timwaizenegger/rfblaster/doc/04-smarthome.pdf

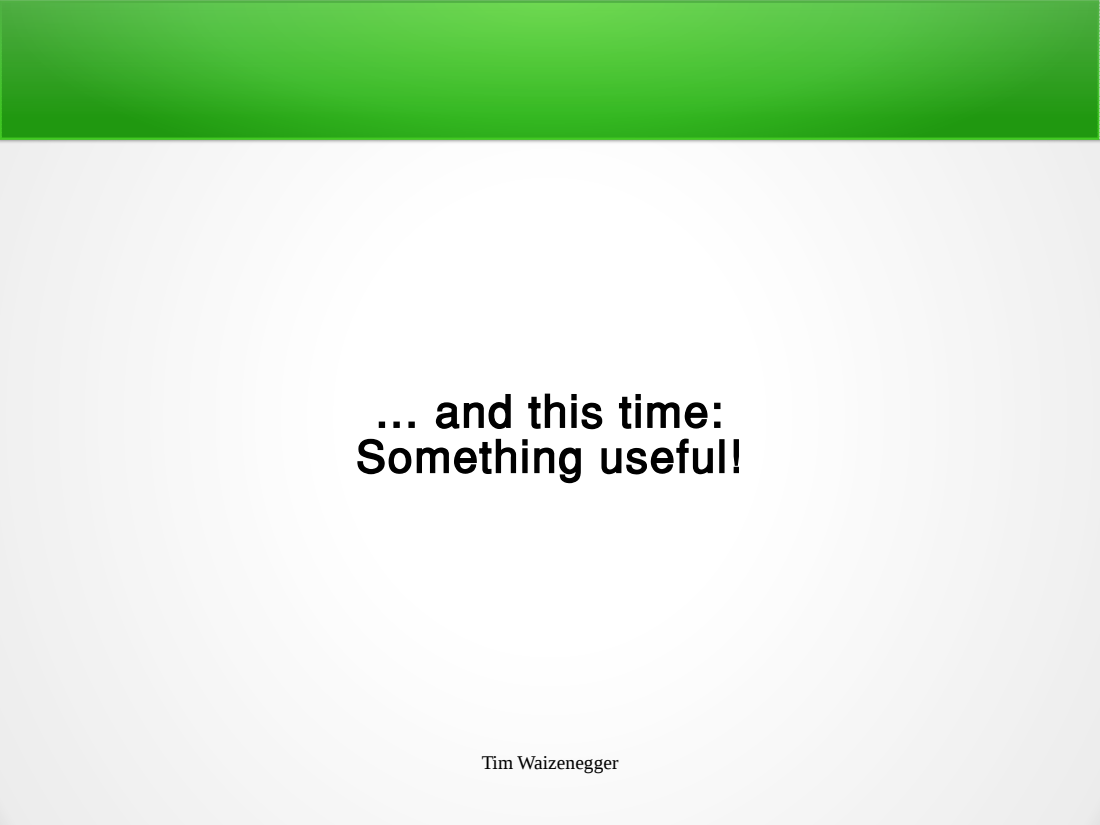
[picture p10: page 1]
Tim Waizenegger

… and this time:
Something useful!

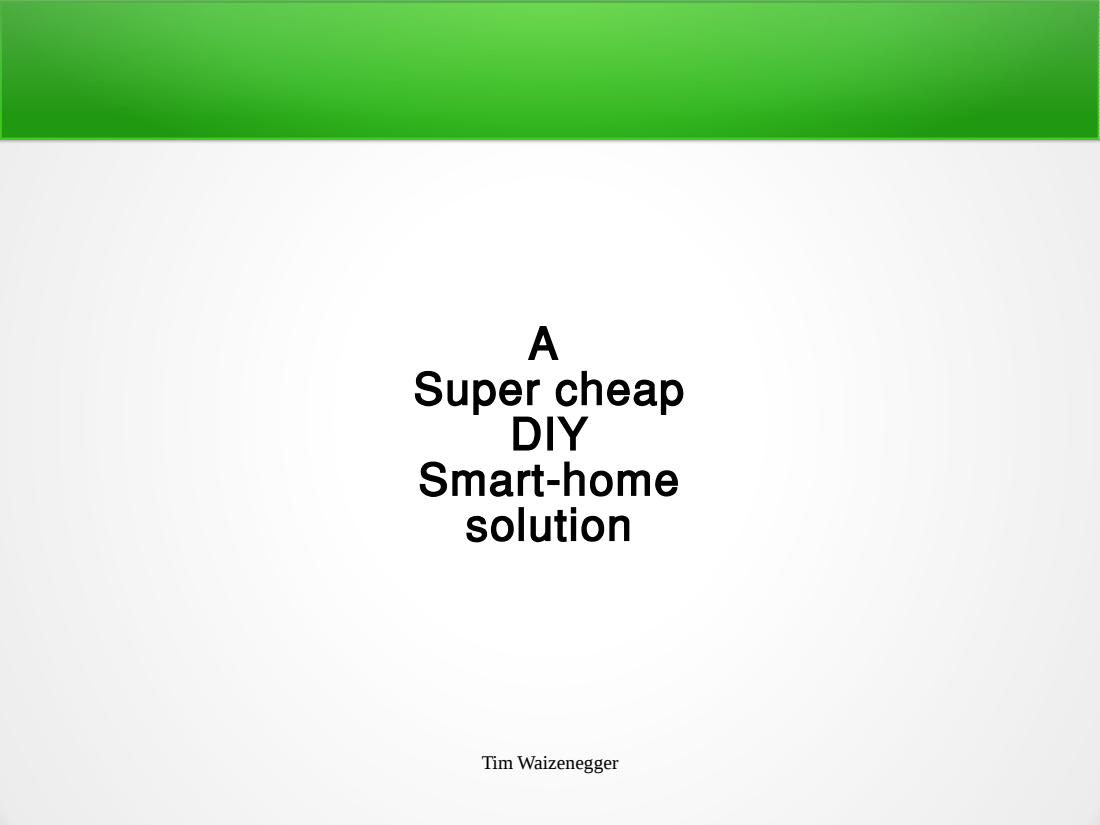
[picture p11: page 2]
A Super cheap DIY Smart-home solution

## Agenda

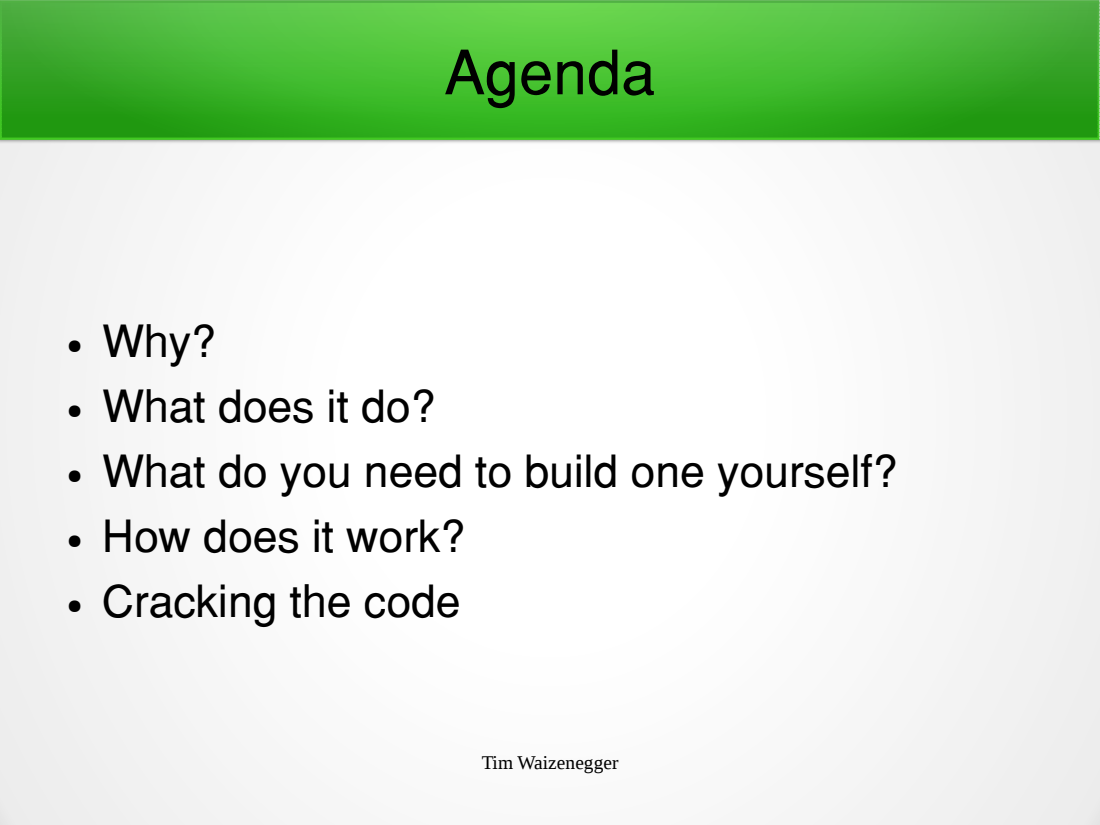
[picture p12: page 3]

● Why?
● What does it do?
● What do you need to build one yourself?
● How does it work?
● Cracking the code

## Why?

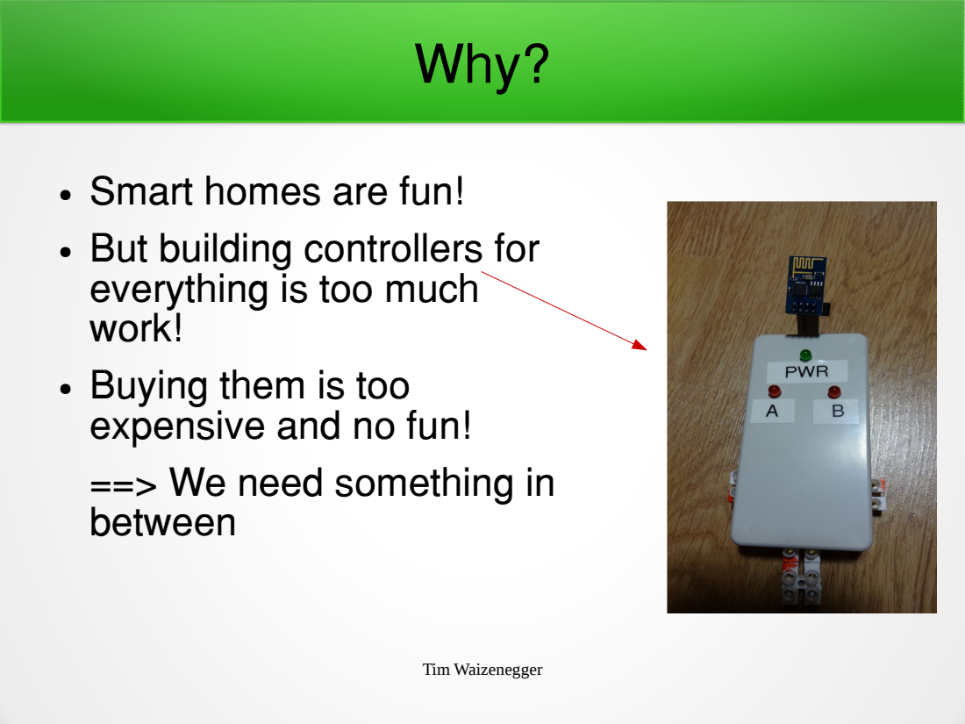
[picture p13: page 4]

● Smart homes are fun!
● But building controllers for
everything is too much
work!
● Buying them is too
expensive and no fun!
==> We need something in
between

## What does it do?

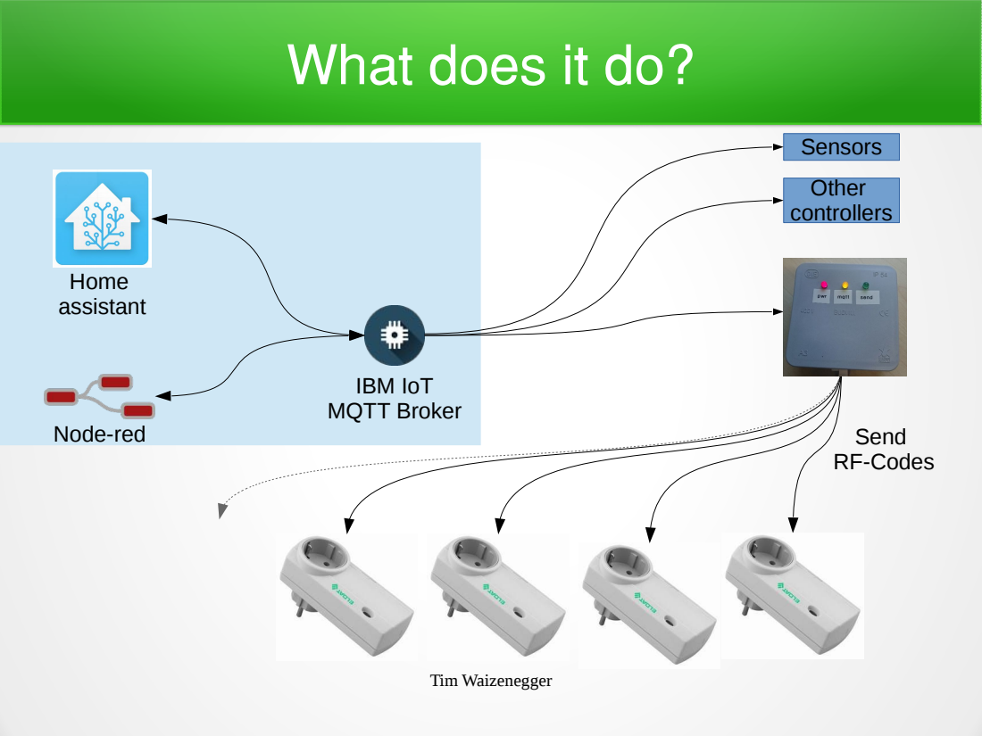
[picture p14: page 5]
IBM IoT MQTT Broker; Node-red; Send; RF-Codes; Home assistant; Sensors; Other controllers

## What you need

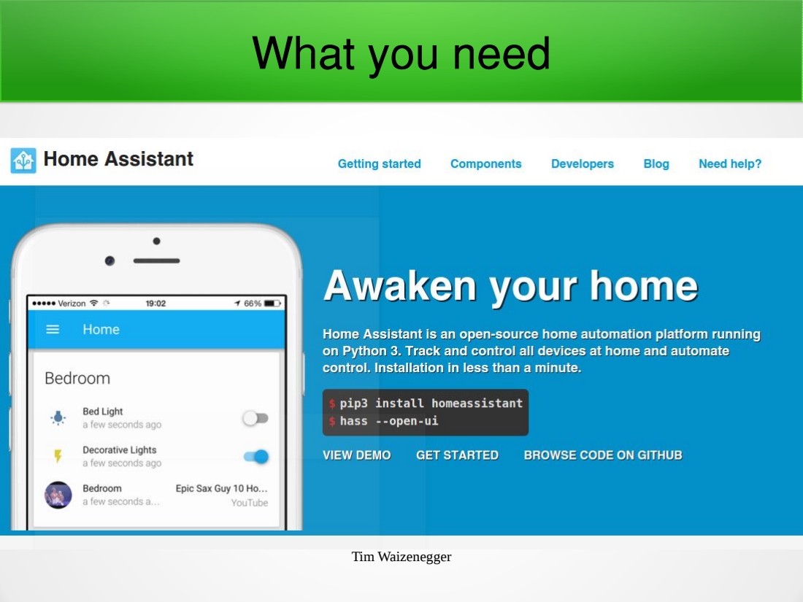
[picture p15: page 6]

## What you need

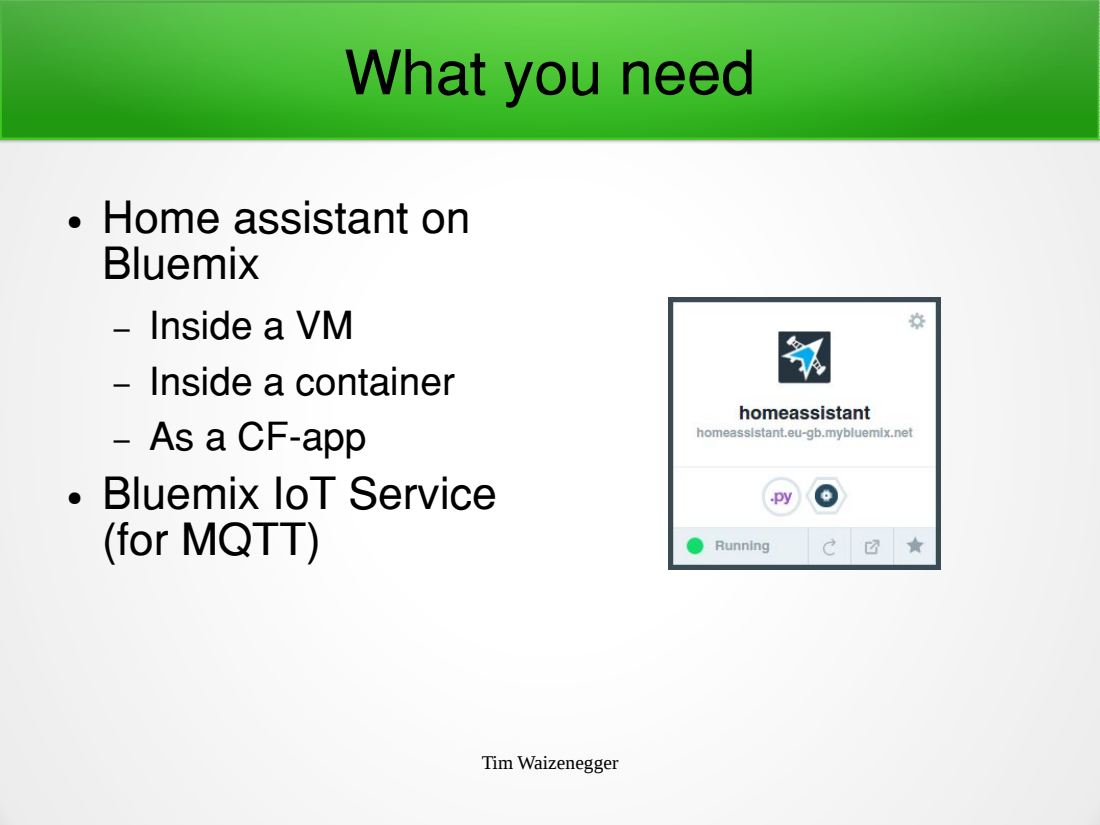
[picture p16: page 7]

● Home assistant on
Bluemix
– Inside a VM
– Inside a container
– As a CF-app
● Bluemix IoT Service
(for MQTT)

## What you need

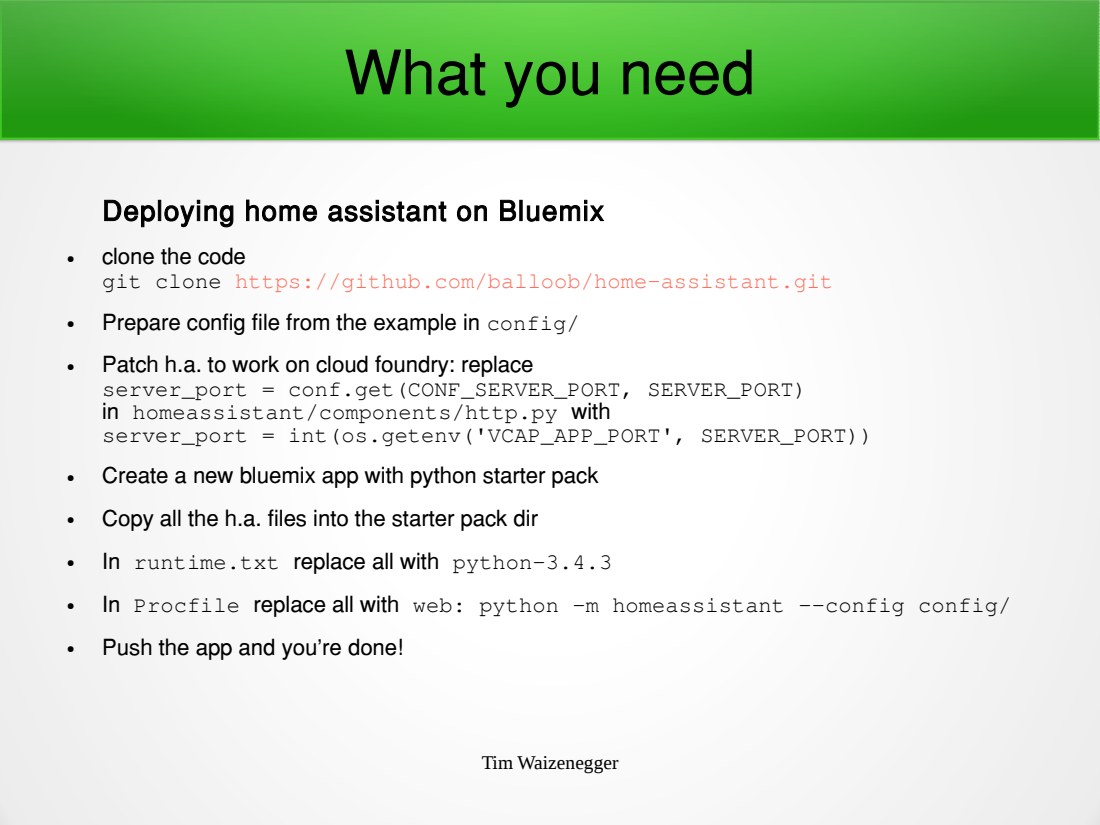
[picture p17: page 8]

Deploying home assistant on Bluemix
● clone the code
git clone https://github.com/balloob/home-assistant.git
● Prepare config file from the example in config/
● Patch h.a. to work on cloud foundry: replace
server_port = conf.get(CONF_SERVER_PORT, SERVER_PORT)
in homeassistant/components/http.py with
server_port = int(os.getenv('VCAP_APP_PORT', SERVER_PORT))
● Create a new bluemix app with python starter pack
● Copy all the h.a. files into the starter pack dir

● In runtime.txt replace all with python-3.4.3

● In Procfile replace all with web: python -m homeassistant --config config/
● Push the app and you're done!

## What you need

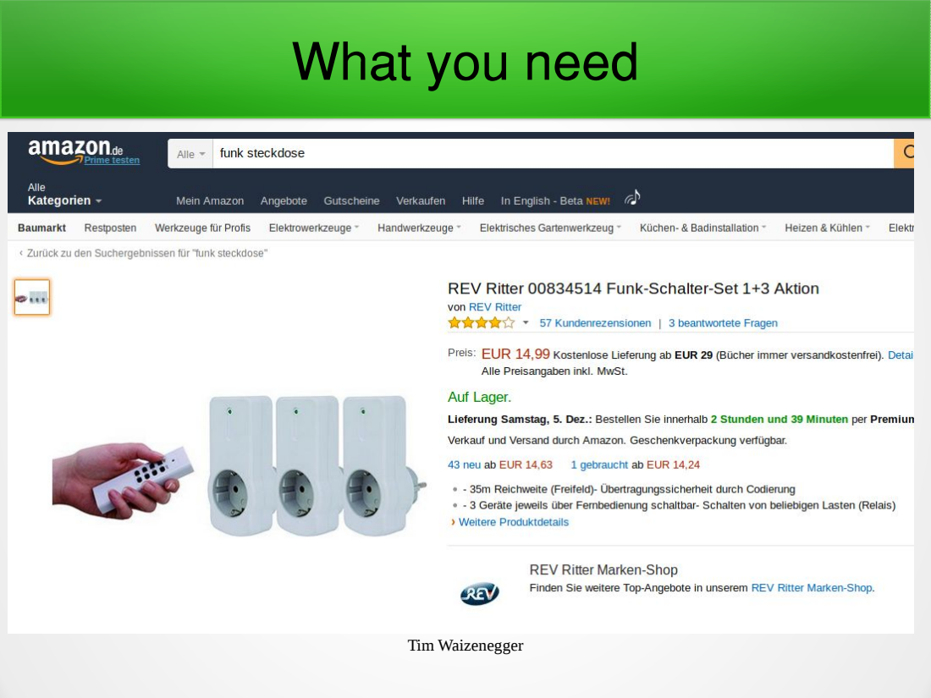
[picture p18: page 9]

## What you need

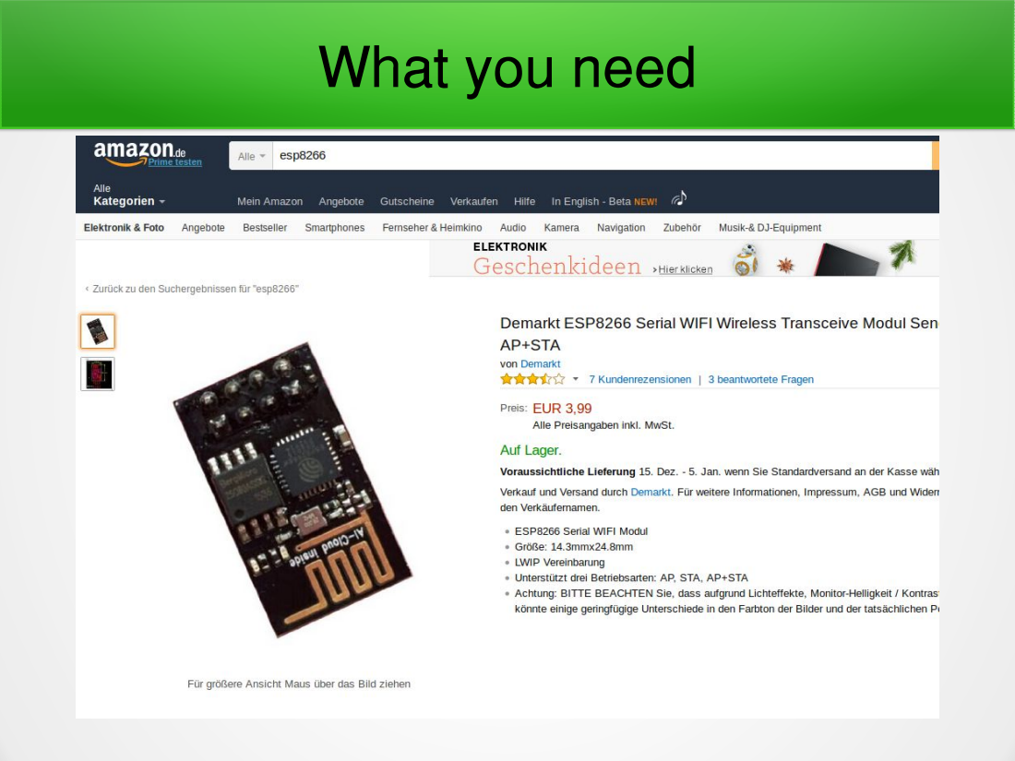
[picture p19: page 10]

## What you need

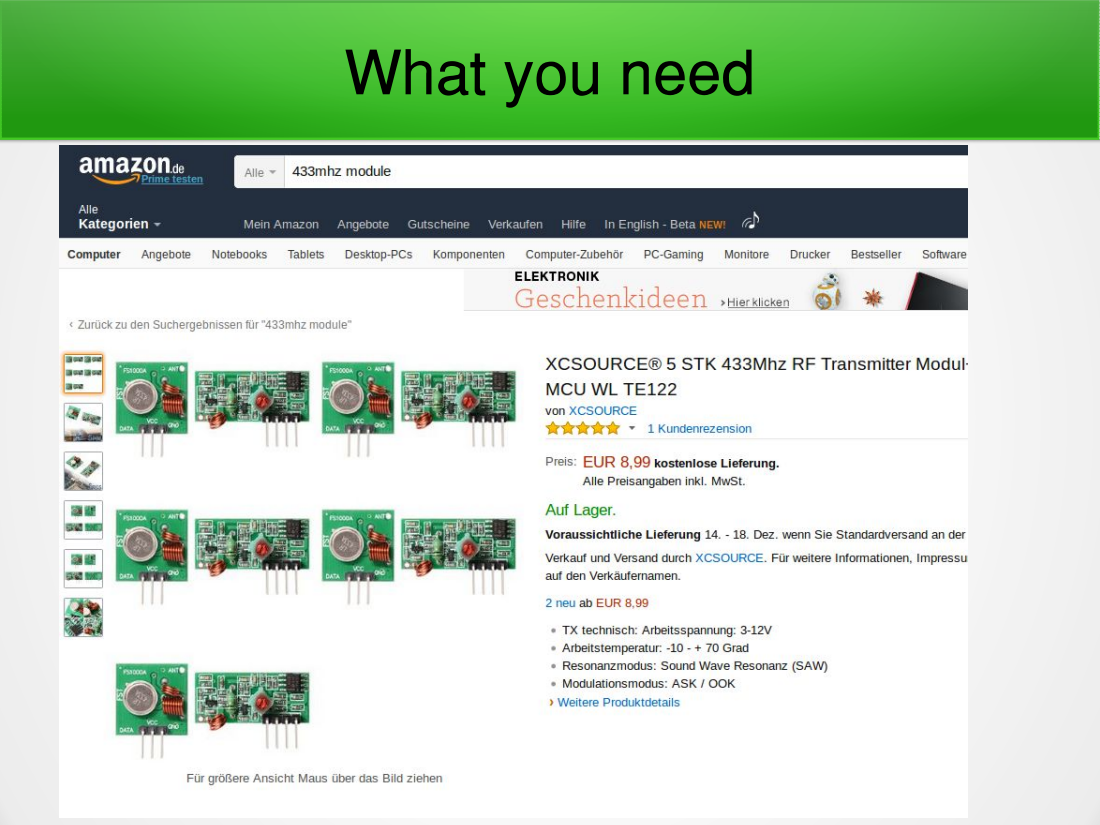
[picture p20: page 11]

## What you need

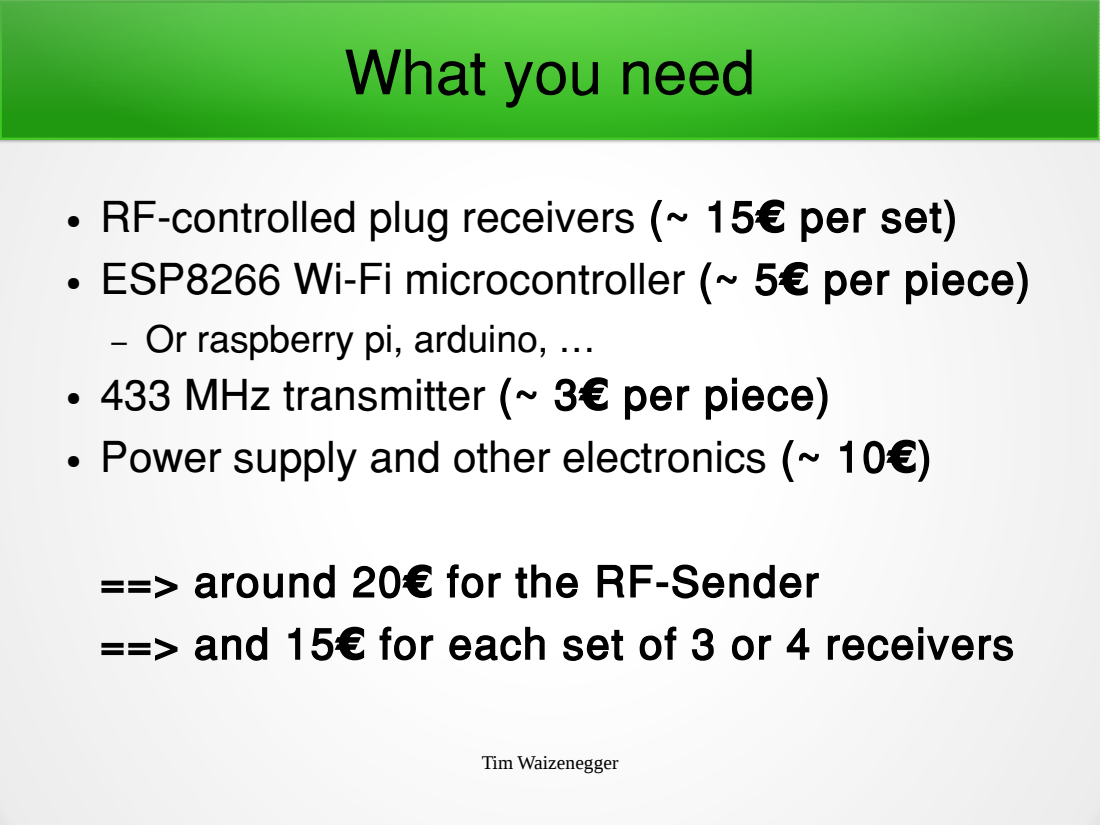
[picture p21: page 12]

● RF-controlled plug receivers (~ 15 per set) €
● ESP8266 Wi-Fi microcontroller (~ 5 per piece) €
– Or raspberry pi, arduino, …
● 433 MHz transmitter (~ 3 per piece) €
● Power supply and other electronics (~ 10 ) €

==> around 20 for the RF-Sender €
==> and 15 for each set of 3 or 4 receivers €

## How does it work?

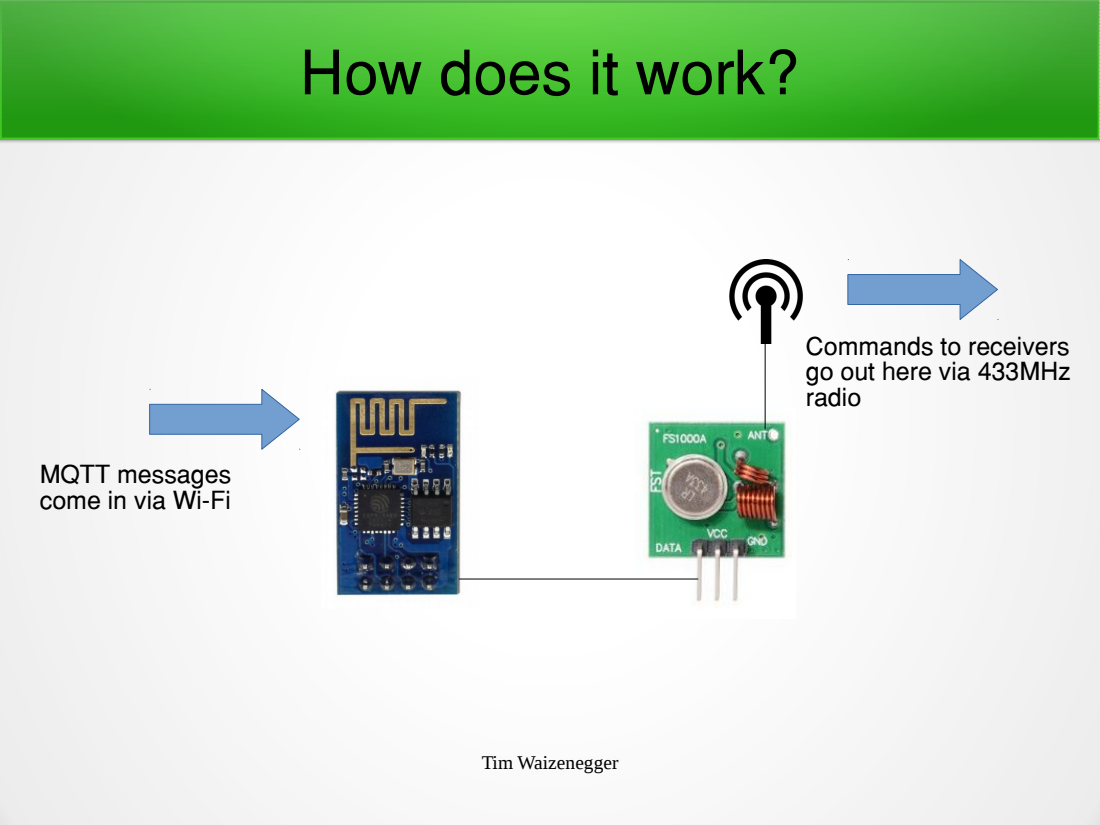
[picture p22: page 13]

Commands to receivers
go out here via 433MHz
radio

MQTT messages
come in via Wi-Fi

## Wireless protocol

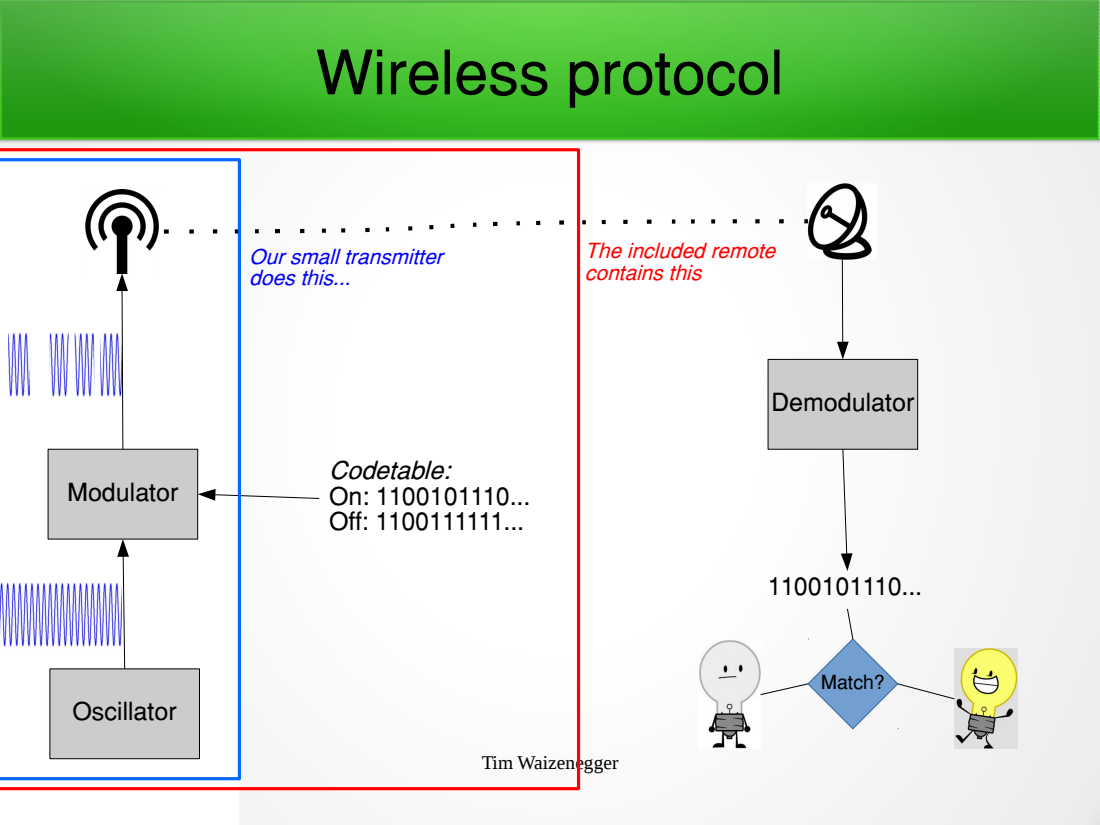
[picture p23: page 14]
Modulator; Codetable: On: 1100101110... Off: 1100111111...; Demodulator; Oscillator; Match?

The included remote
contains this

Our small transmitter
does this...

## Cracking the code

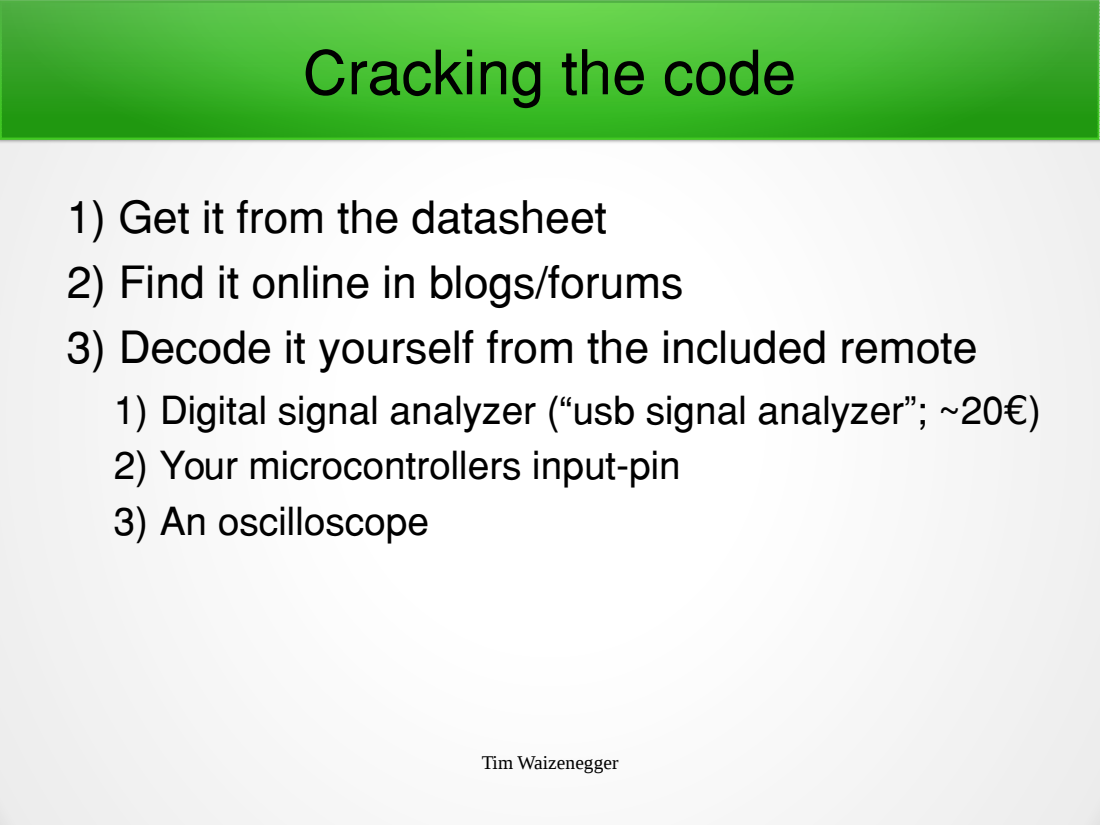
[picture p24: page 15]

1) Get it from the datasheet
2) Find it online in blogs/forums
3) Decode it yourself from the included remote
1) Digital signal analyzer (“usb signal analyzer”; ~20 ) €
2) Your microcontrollers input-pin
3) An oscilloscope

## Code Example

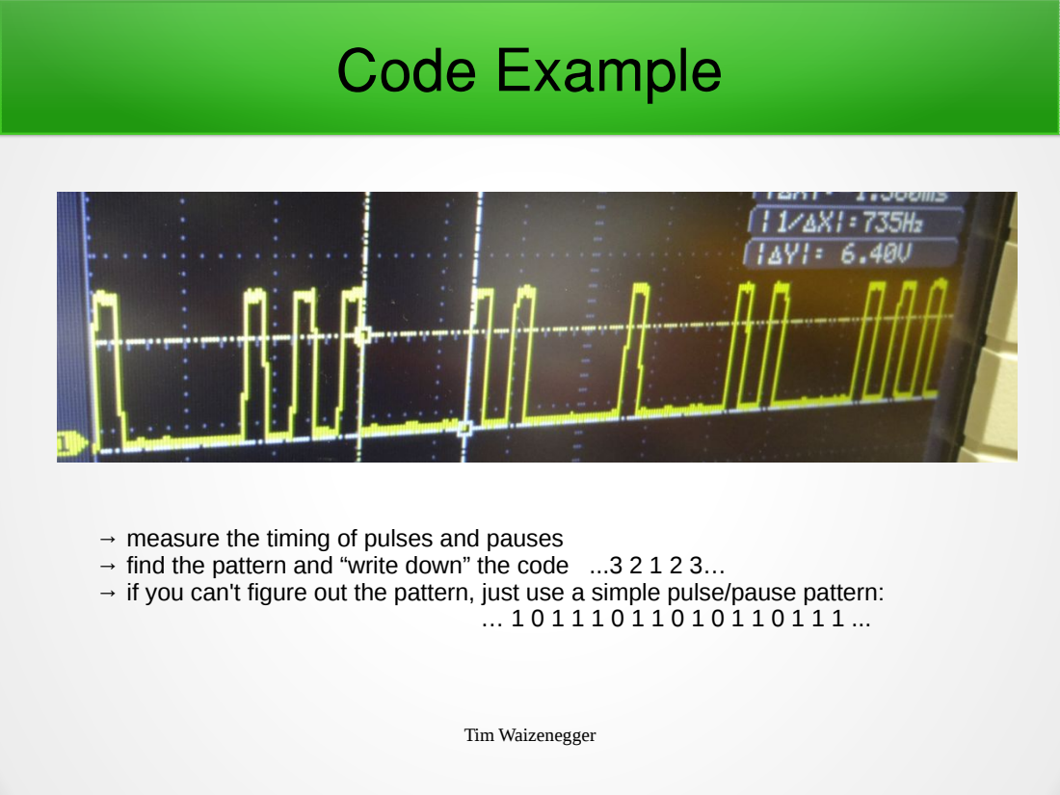
[picture p25: page 16]

→ measure the timing of pulses and pauses
→ find the pattern and “write down” the code ...3 2 1 2 3…
→ if you can't figure out the pattern, just use a simple pulse/pause pattern:

## Reproduce the code

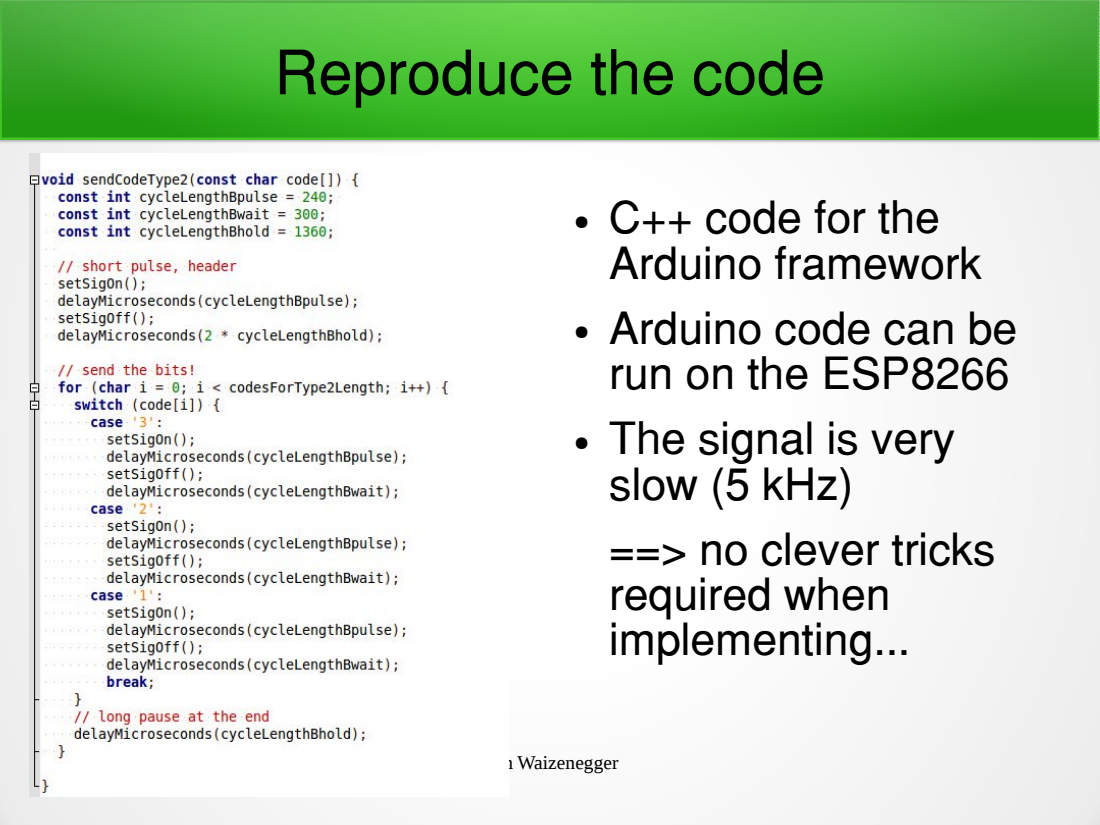
[picture p26: page 17]

● C++ code for the
Arduino framework
● Arduino code can be
run on the ESP8266
● The signal is very
slow (5 kHz)
==> no clever tricks
required when
implementing...

## Some of the codes I found

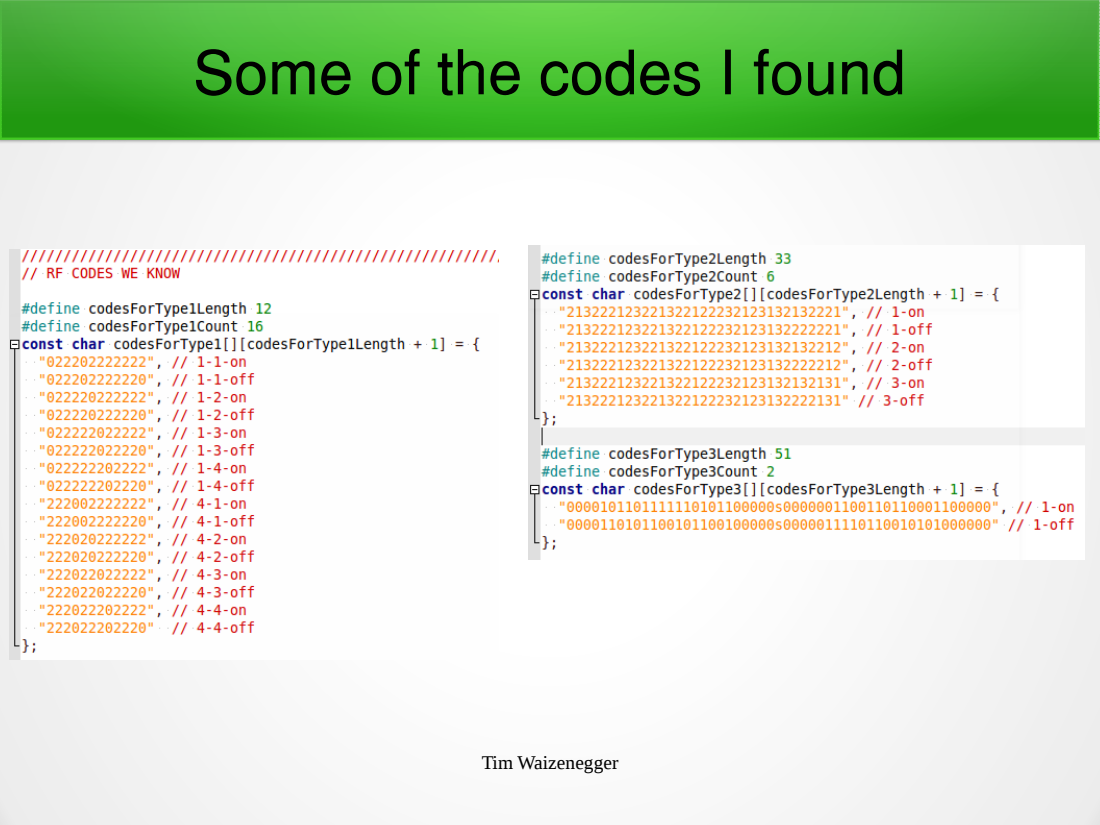
[picture p27: page 18]

And next time...

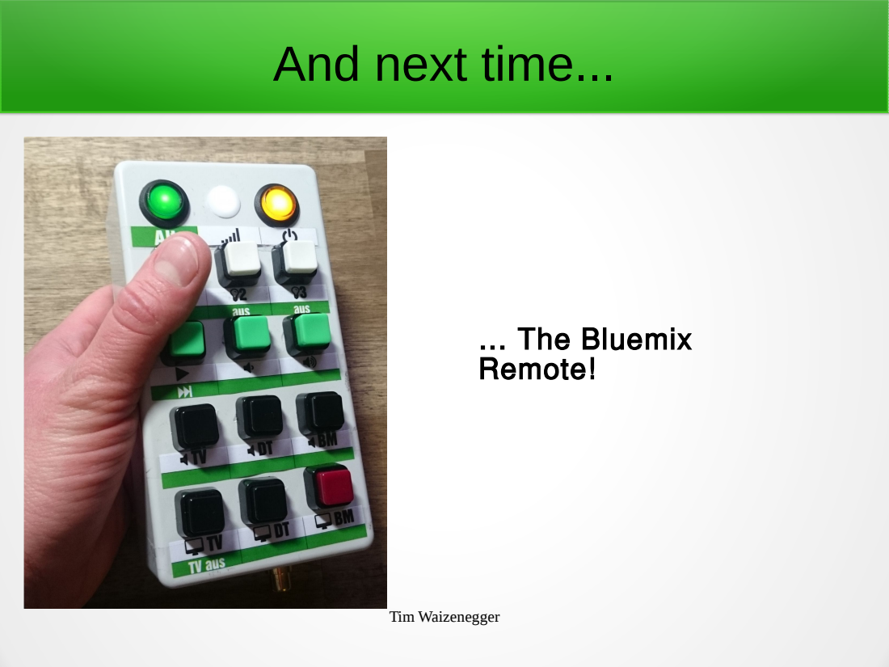
[picture p28: page 19]
… The Bluemix Remote!
